mhorimoto/Q920/モバイルバッテリーアダプターの製作.pdf

## モバイルバッテリーアダプターの製作

## 製作の背景

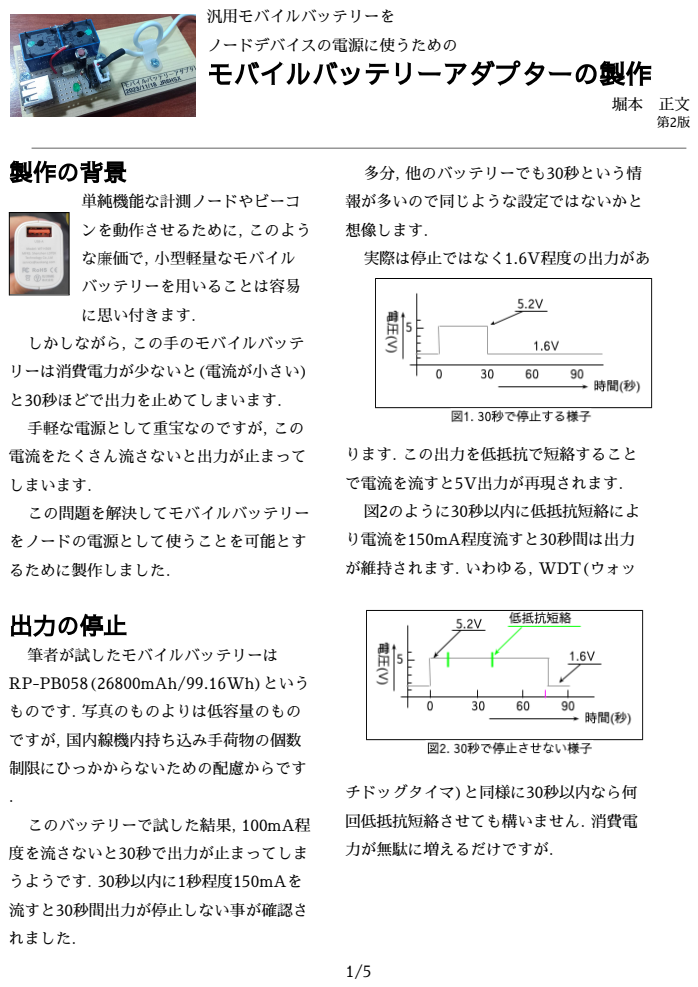
[picture p1: page 1]
汎用モバイルバッテリーを ノードデバイスの電源に使うための; 単純機能な計測ノードやビーコ ンを動作させるために，このよう な廉価で，小型軽量なモバイル バッテリーを用いることは容易 に思い付きます． しかしながら，この手のモバイルバッテ リーは消費電力が少ないと(電流が小さい) と30秒ほどで出力を止めてしまいます． 手軽な電源として重宝なのですが，この 電流をたくさん流さないと出力が止まって しまいます． この問題を解決してモバイルバッテリー をノードの電源として使うことを可能とす るために製作しました．; 出力の停止; 筆者が試したモバイルバッテリーは RP-PB058(26800mAh/99.16Wh)という ものです．写真のものよりは低容量のもの ですが，国内線機内持ち込み手荷物の個数 制限にひっかからないための配慮からです; このバッテリーで試した結果，100mA程 度を流さないと30秒で出力が止まってしま うようです．30秒以内に1秒程度150mAを 流すと30秒間出力が停止しない事が確認さ れました．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

## 回路設計

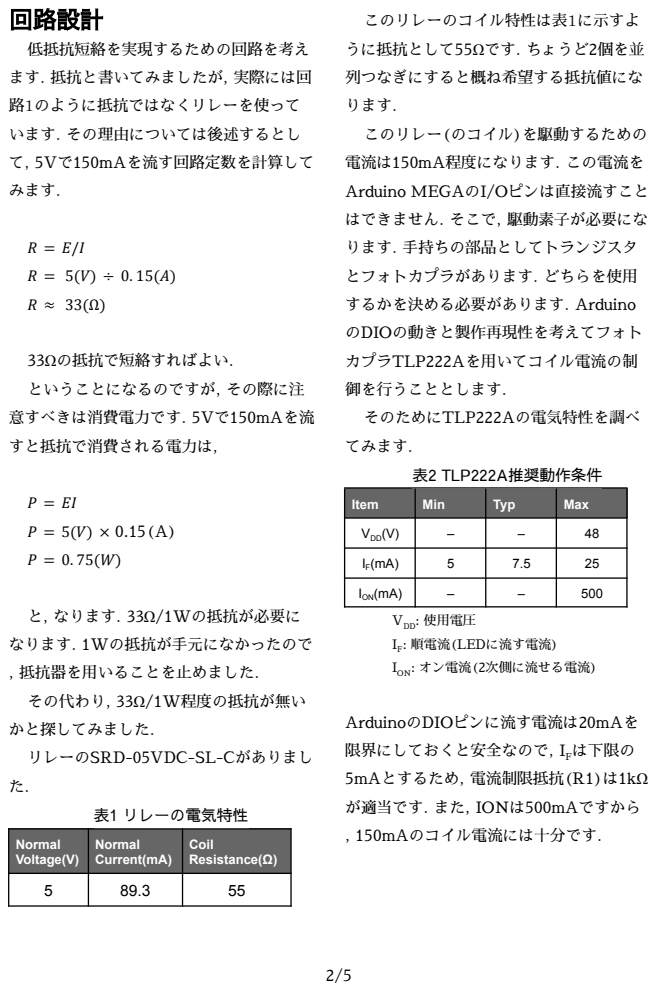
[picture p2: page 2]
低抵抗短絡を実現するための回路を考え ます．抵抗と書いてみましたが，実際には回 路１のように抵抗ではなくリレーを使って います．その理由については後述するとし て，5Vで150mAを流す回路定数を計算して みます．; 33Ωの抵抗で短絡すればよい． ということになるのですが，その際に注 意すべきは消費電力です．5Vで150mAを流 すと抵抗で消費される電力は，; と，なります．33Ω/1Wの抵抗が必要に なります．1Wの抵抗が手元になかったので ，抵抗器を用いることを止めました． その代わり，33Ω/1W程度の抵抗が無い かと探してみました． リレーのSRD-05VDC-SL-Cがありまし た．; 表1 リレーの電気特性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

Item | Min | Typ | Max

VDD(V) | – | – | 48

ION(mA) | – | – | 500

Normal Voltage(V) | Normal Current(mA) | Coil Resistance(Ω)

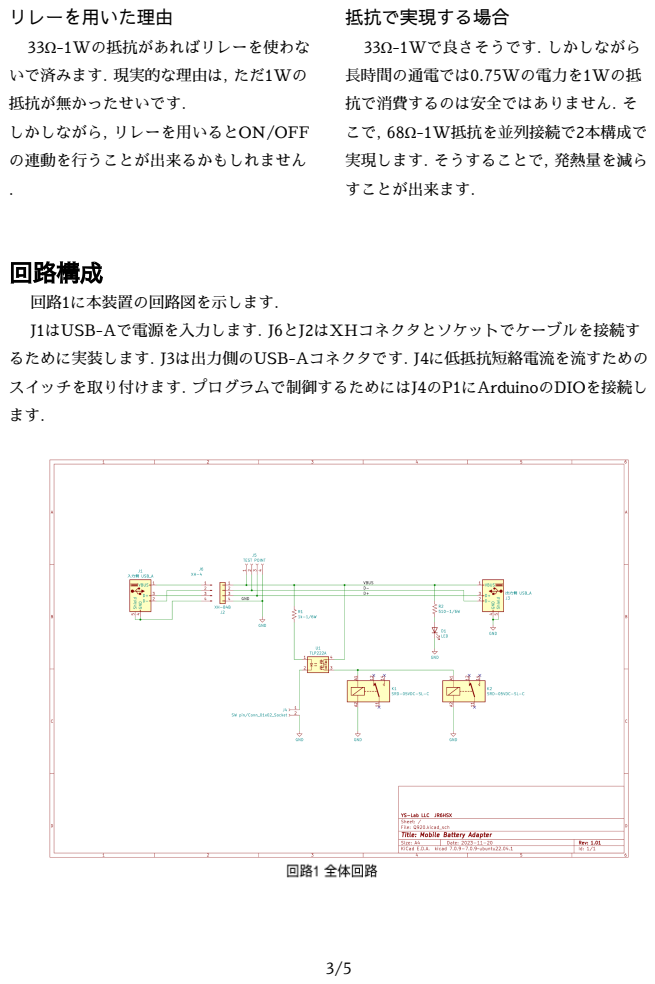
[picture p3: page 3]
リレーを用いた理由; 33Ω-1Wの抵抗があればリレーを使わな いで済みます．現実的な理由は，ただ1Wの 抵抗が無かったせいです． しかしながら，リレーを用いるとON/OFF の連動を行うことが出来るかもしれません; 抵抗で実現する場合; 33Ω-1Wで良さそうです．しかしながら 長時間の通電では0.75Wの電力を1Wの抵 抗で消費するのは安全ではありません．そ こで，68Ω-1W抵抗を並列接続で2本構成で 実現します．そうすることで，発熱量を減ら すことが出来ます．; 回路構成; 回路1に本装置の回路図を示します． J1はUSB-Aで電源を入力します．J6とJ2はXHコネクタとソケットでケーブルを接続す るために実装します．J3は出力側のUSB-Aコネクタです．J4に低抵抗短絡電流を流すための スイッチを取り付けます．プログラムで制御するためにはJ4のP1にArduinoのDIOを接続し ます．

## 製品の完成

## Arduinoとの接続

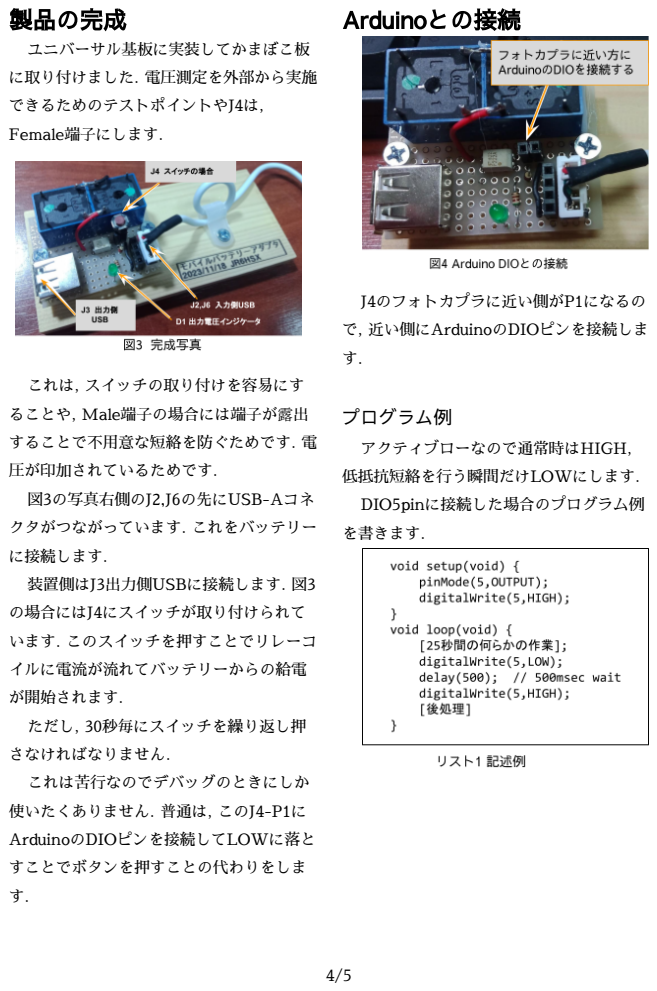
[picture p4: page 4]
ユニバーサル基板に実装してかまぼこ板 に取り付けました．電圧測定を外部から実施 できるためのテストポイントやJ4は， Female端子にします．; これは，スイッチの取り付けを容易にす ることや，Male端子の場合には端子が露出 することで不用意な短絡を防ぐためです．電 圧が印加されているためです． 図3の写真右側のJ2,J6の先にUSB-Aコネ クタがつながっています．これをバッテリー に接続します． 装置側はJ3出力側USBに接続します．図3 の場合にはJ4にスイッチが取り付けられて います．このスイッチを押すことでリレーコ イルに電流が流れてバッテリーからの給電 が開始されます． ただし，30秒毎にスイッチを繰り返し押 さなければなりません． これは苦行なのでデバッグのときにしか 使いたくありません．普通は，このJ4-P1に ArduinoのDIOピンを接続してLOWに落と すことでボタンを押すことの代わりをしま す．; J4のフォトカプラに近い側がP1になるの で，近い側にArduinoのDIOピンを接続しま す．; プログラム例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

## メリットの計算

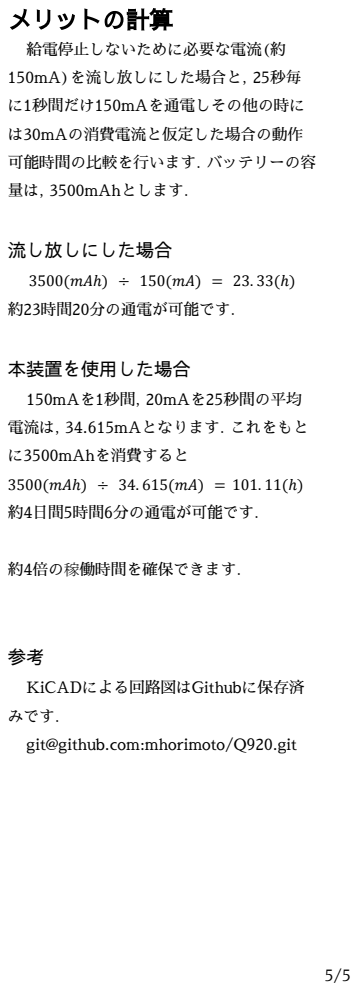
[picture p5: page 5]
給電停止しないために必要な電流(約 150mA)を流し放しにした場合と，25秒毎 に1秒間だけ150mAを通電しその他の時に は30mAの消費電流と仮定した場合の動作 可能時間の比較を行います．バッテリーの容 量は，3500mAhとします．; 流し放しにした場合; 3500(mAℎ) ÷ 150(mA) = 23. 33(ℎ) 約23時間20分の通電が可能です．; 本装置を使用した場合; 150mAを1秒間，20mAを25秒間の平均 電流は，34.615mAとなります．これをもと に3500mAhを消費すると; 3500(mAℎ) ÷ 34. 615(mA) = 101. 11(ℎ) 約4日間5時間6分の通電が可能です．; 約4倍の稼働時間を確保できます．

KiCADによる回路図はGithubに保存済
みです．
git@github.com:mhorimoto/Q920.git
