mhorimoto/Q920/Q920-sch.pdf

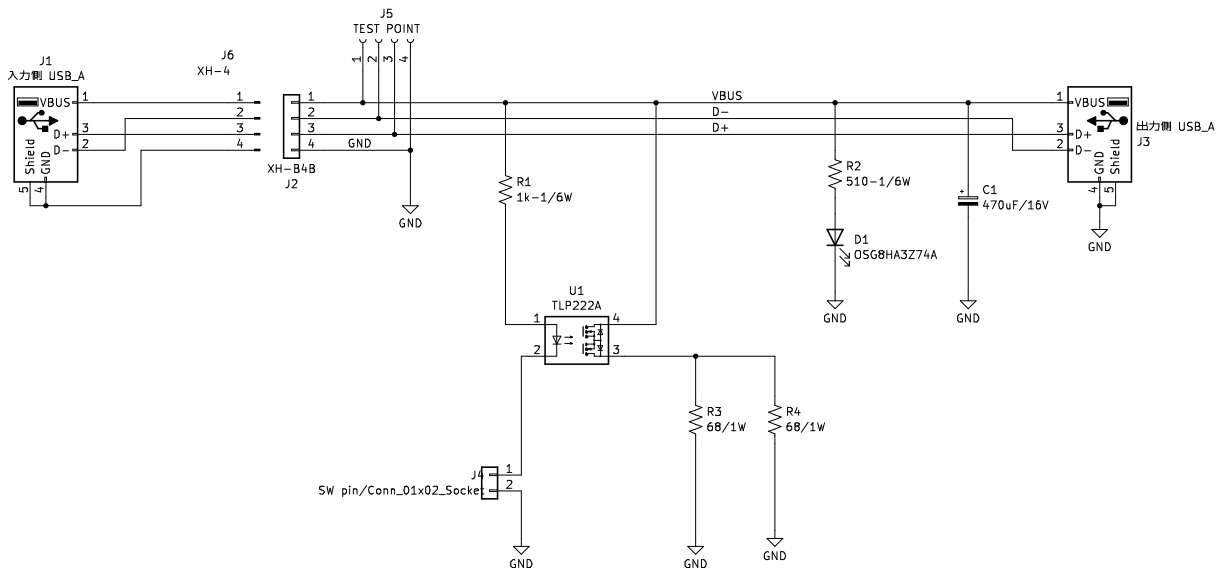
[picture p6: page 1]
