mhorimoto/Q920/Q920.kicad_pcb

## KiCad design Q920.kicad_pcb (2023-11-27)

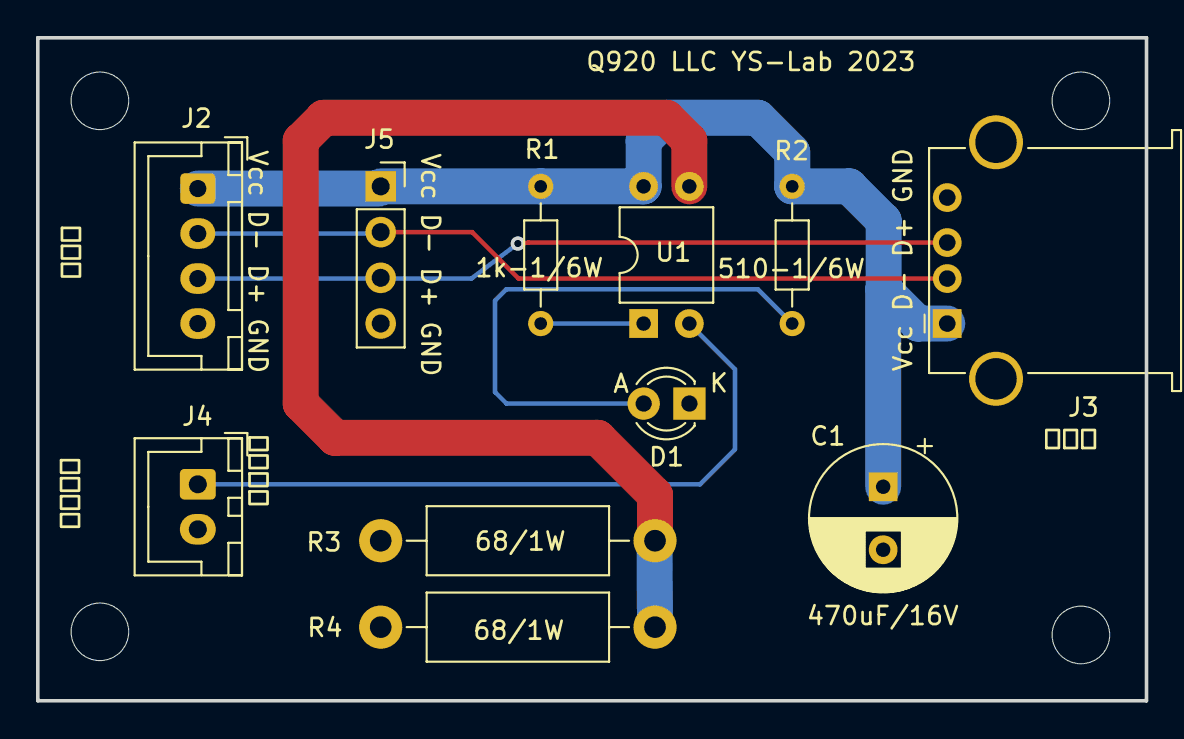
[picture p7: board Q920.kicad_pcb from above]

Board: 2 copper layers, 61.6 x 36.8 mm, 11 parts (0 on the bottom side), 8 nets.

Parts:
C1: 470uF/16V; CP_Radial_D8.0mm_P3.50mm
D1: OSG8HA3Z74A; LED_D3.0mm
J2: XH-B4B; JST_XH_B4B-XH-A_1x04_P2.50mm_Vertical
J3: 出力側 USB_A; USB_A_Stewart_SS-52100-001_Horizontal
J4: SW pin/Conn_01x02_Socket; JST_XH_B2B-XH-A_1x02_P2.50mm_Vertical
J5: TEST POINT; PinSocket_1x04_P2.54mm_Vertical
R1: 1k-1/6W; R_Axial_DIN0204_L3.6mm_D1.6mm_P7.62mm_Horizontal
R2: 510-1/6W; R_Axial_DIN0204_L3.6mm_D1.6mm_P7.62mm_Horizontal
R3, R4: 68/1W; R_Axial_DIN0411_L9.9mm_D3.6mm_P15.24mm_Horizontal
U1: TLP222A; DIP-4_W7.62mm

Connections:
/D+: J2.3, J3.3 (D+), J5.3
/D-: J2.2, J3.2 (D-), J5.2
/VBUS: C1.1, J2.1, J3.1 (VBUS), J5.1, R1.1, R2.1, U1.4
GND: C1.2, D1.1 (K), J2.4, J3.4 (GND), J3.5 (Shield), J4.2, J5.4, R3.2, R4.2
unnamed: D1.2 (A), R2.2
unnamed: J4.1, U1.2
unnamed: R1.2, U1.1
unnamed: R3.1, R4.1, U1.3
