mhorimoto/Q920/(commit log)

2023-11-20 sche: 不要な配線を消す。ドキュメント整備
    [Q920.kicad_sch]
2023-11-20 PCB基板化
    [Q920.kicad_pcb, Q920.kicad_sch]
2023-11-27 cad: リレーを抵抗に変更した
    [Q920.kicad_pcb, Q920.kicad_sch]
2023-11-27 rel: ver 2.00
    [Q920.kicad_sch]
2023-11-27 pcb: 社名変更
    [Q920.kicad_pcb]
